EDD2526/edd-project-grup-dimecres-dc_c_seients/KiCad/proj_seients/proj_seients.kicad_pcb

## KiCad design KiCad/proj_seients/proj_seients.kicad_pcb (2026-04-28)

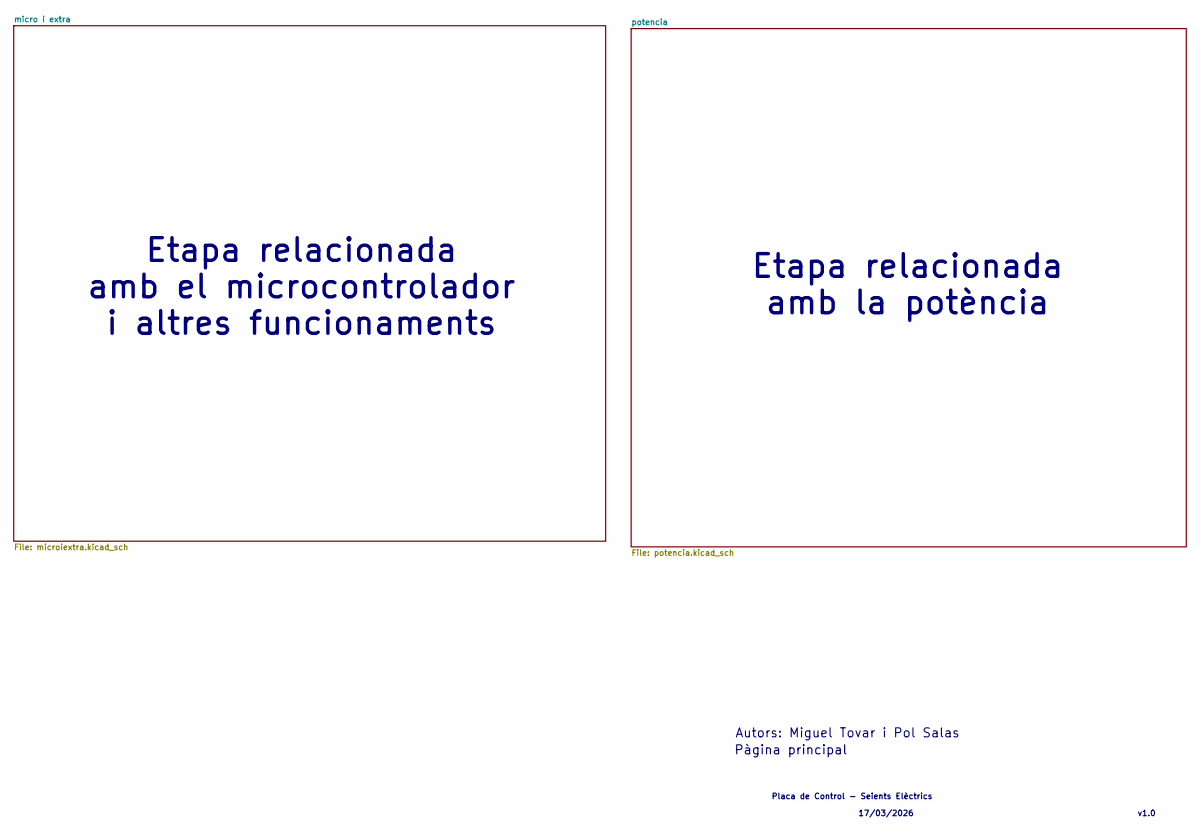
[picture p2: schematic proj_seients.kicad_sch]

Notes on the sheet:
v1.0
Etapa relacionada amb el microcontrolador i altres funcionaments
Placa de Control - Seients Elèctrics
Etapa relacionada amb la potència
17/03/2026
Pàgina principal
Autors: Miguel Tovar i Pol Salas

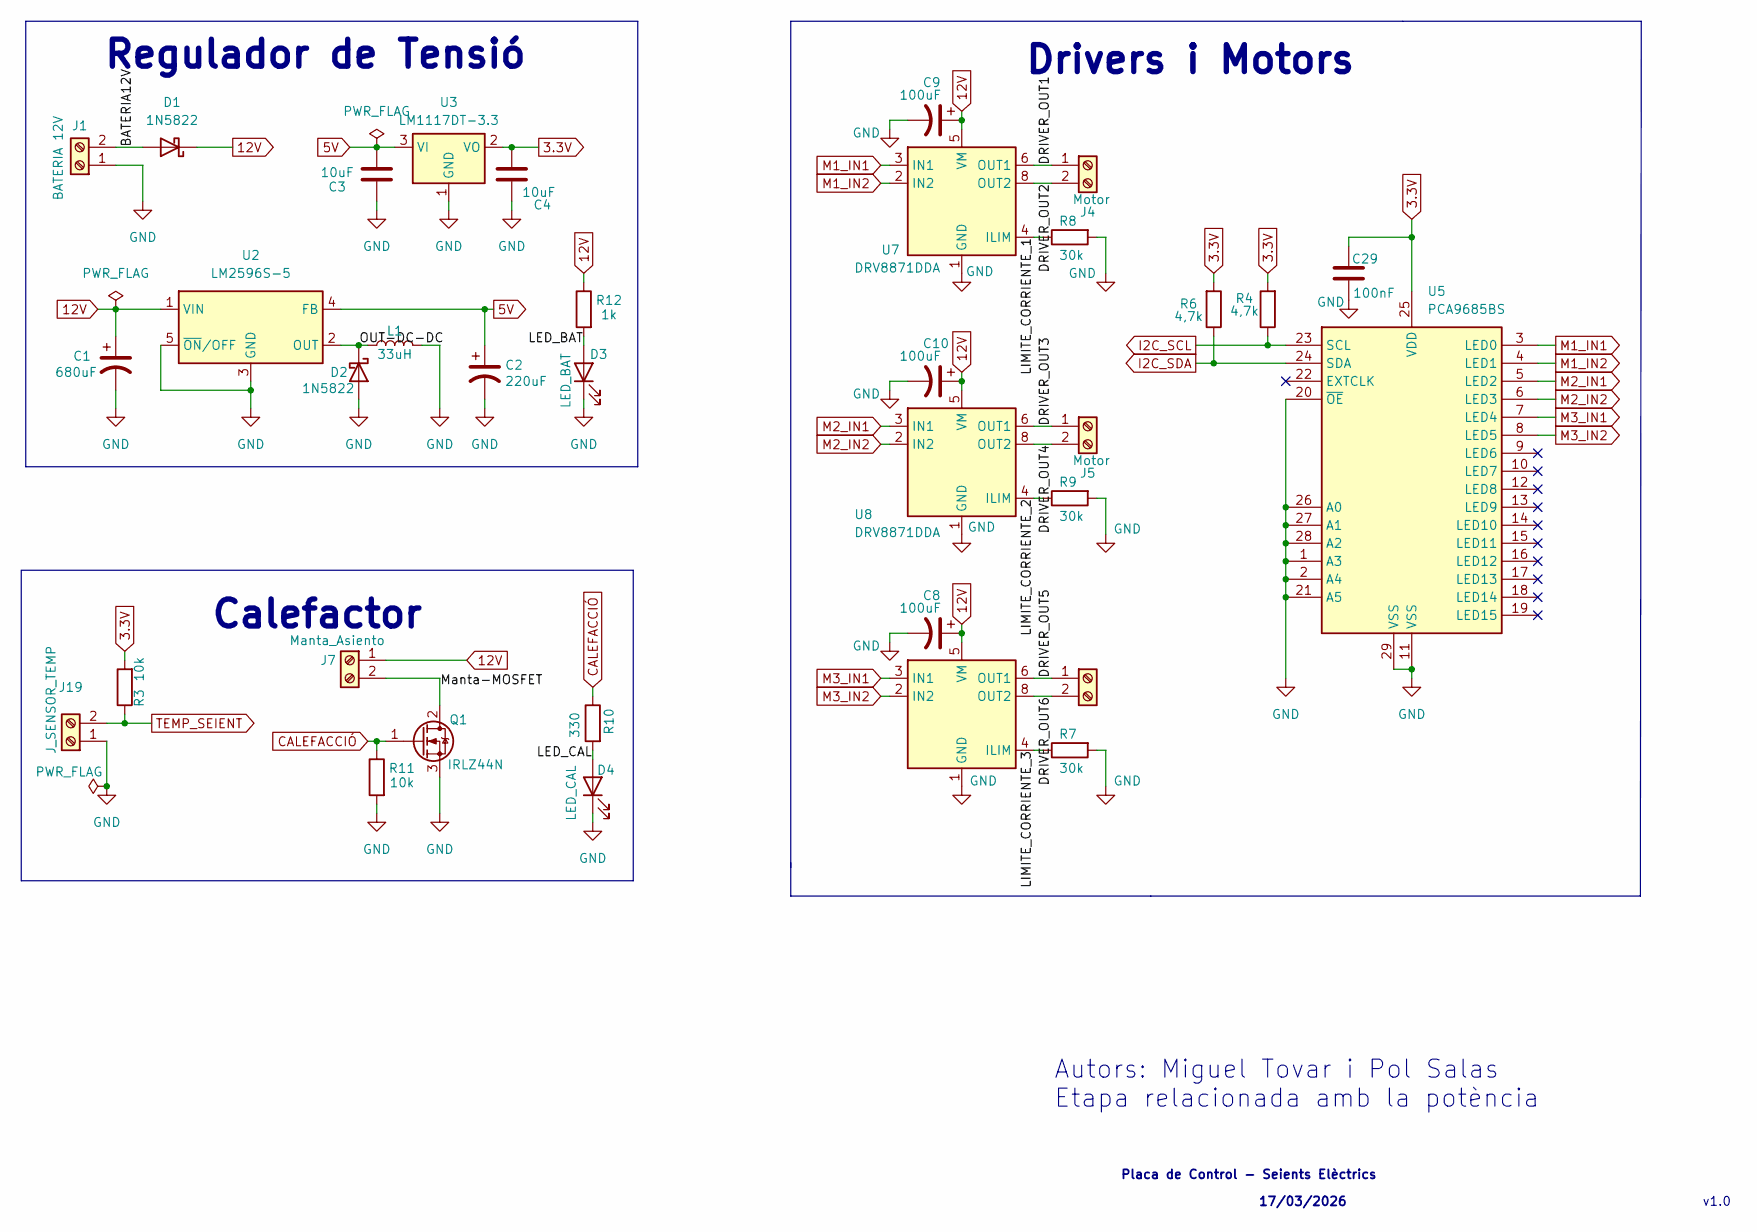
[picture p3: schematic potencia.kicad_sch]

Parts:
C1: 680uF; CP_Radial_D10.0mm_P5.00mm
C2: 220uF; CP_Radial_D8.0mm_P3.50mm
C3, C4: 10uF; C_0805_2012Metric
C8, C9, C10: 100uF; CP_Radial_D8.0mm_P3.50mm
C29: 100nF; C_0805_2012Metric
D1, D2: 1N5822; D_DO-201AD_P15.24mm_Horizontal
D3: LED_BAT; LED_0805_2012Metric
D4: LED_CAL; LED_0805_2012Metric
J1: BATERIA 12V; TerminalBlock_Phoenix_MKDS-1,5-2-5.08_1x02_P5.08mm_Horizont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
J4, J5, J6: Motor; TerminalBlock_Phoenix_MKDS-1,5-2-5.08_1x02_P5.08mm_Horizont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
J7: Manta_Asiento; TerminalBlock_Phoenix_MKDS-1,5-2-5.08_1x02_P5.08mm_Horizont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
J19: J_SENSOR_TEMP; TerminalBlock_Phoenix_MKDS-1,5-2-5.08_1x02_P5.08mm_Horizont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
L1: 33uH; L_Radial_D10.0mm_P5.00mm_Fastron_07M
Q1: IRLZ44N; TO-220-3_Vertical
R3, R11: 10k; R_0805_2012Metric
R4, R6: 4,7k; R_0805_2012Metric
R7, R8, R9: 30k; R_0805_2012Metric
R10: 330; R_0805_2012Metric
R12: 1k; R_0805_2012Metric
U2: LM2596S-5; TO-263-5_TabPin3
U3: LM1117DT-3.3; TO-252-3_TabPin2
U5: PCA9685BS; QFN-28-1EP_6x6mm_P0.65mm_EP4.25x4.25mm
U6, U7, U8: DRV8871DDA; Texas_HTSOP-8-1EP_3.9x4.9mm_P1.27mm_EP2.95x4.9mm_Mask2.4x3.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

Connections:
3.3V: C4.2, C29.2, R3.2, R4.2, R6.2, U3.2 (VO), U5.25 (VDD); also elsewhere on the board
5V: C2.1, C3.2, U2.4 (FB), U3.3 (VI); also elsewhere on the board
12V: C1.1, C8.1, C9.1, C10.1, D1.1 (K), J7.1, R12.1, U2.1 (VIN), U6.5 (VM), U7.5 (VM), U8.5 (VM); also elsewhere on the board
/potencia/BATERIA12V: D1.2 (A), J1.2
/potencia/DRIVER_OUT1: J4.1, U7.6 (OUT1)
/potencia/DRIVER_OUT2: J4.2, U7.8 (OUT2)
/potencia/DRIVER_OUT3: J5.1, U8.6 (OUT1)
/potencia/DRIVER_OUT4: J5.2, U8.8 (OUT2)
/potencia/DRIVER_OUT5: J6.1, U6.6 (OUT1)
/potencia/DRIVER_OUT6: J6.2, U6.8 (OUT2)
/potencia/LED_BAT: D3.2 (A), R12.2
/potencia/LED_CAL: D4.2 (A), R10.2
/potencia/LIMITE_CORRIENTE_1: R8.1, U7.4 (ILIM)
/potencia/LIMITE_CORRIENTE_2: R9.1, U8.4 (ILIM)
/potencia/LIMITE_CORRIENTE_3: R7.1, U6.4 (ILIM)
/potencia/Manta-MOSFET: J7.2, Q1.2 (D)
/potencia/OUT-DC-DC: D2.1 (K), L1.1, U2.2 (OUT)
CALEFACCIÓ: Q1.1 (G), R10.1, R11.1; also elsewhere on the board
GND: C1.2, C2.2, C3.1, C4.1, C8.2, C9.2, C10.2, C29.1, D2.2 (A), D3.1 (K), D4.1 (K), J1.1, J19.1, L1.2, Q1.3 (S), R7.2, R8.2, R9.2, R11.2, U2.3 (GND), U2.5 (~ON/OFF), U3.1 (GND), U5.1 (A3), U5.2 (A4), U5.11 (VSS), U5.20 (~OE), U5.21 (A5), U5.26 (A0), U5.27 (A1), U5.28 (A2), U5.29 (VSS), U6.1 (GND), U6.7 (GND), U6.9 (GND), U7.1 (GND), U7.7 (GND), U7.9 (GND), U8.1 (GND), U8.7 (GND), U8.9 (GND); also elsewhere on the board
I2C_SCL: R4.1, U5.23 (SCL); also elsewhere on the board
I2C_SDA: R6.1, U5.24 (SDA); also elsewhere on the board
M1_IN1: U5.3 (LED0), U7.3 (IN1)
M1_IN2: U5.4 (LED1), U7.2 (IN2)
M2_IN1: U5.5 (LED2), U8.3 (IN1)
M2_IN2: U5.6 (LED3), U8.2 (IN2)
M3_IN1: U5.7 (LED4), U6.3 (IN1)
M3_IN2: U5.8 (LED5), U6.2 (IN2)
TEMP_SEIENT: J19.2, R3.1; also elsewhere on the board

Notes on the sheet:
Regulador de Tensió
Placa de Control - Seients Elèctrics
17/03/2026
Drivers i Motors
Calefactor
Autors: Miguel Tovar i Pol Salas Etapa relacionada amb la potència
v1.0

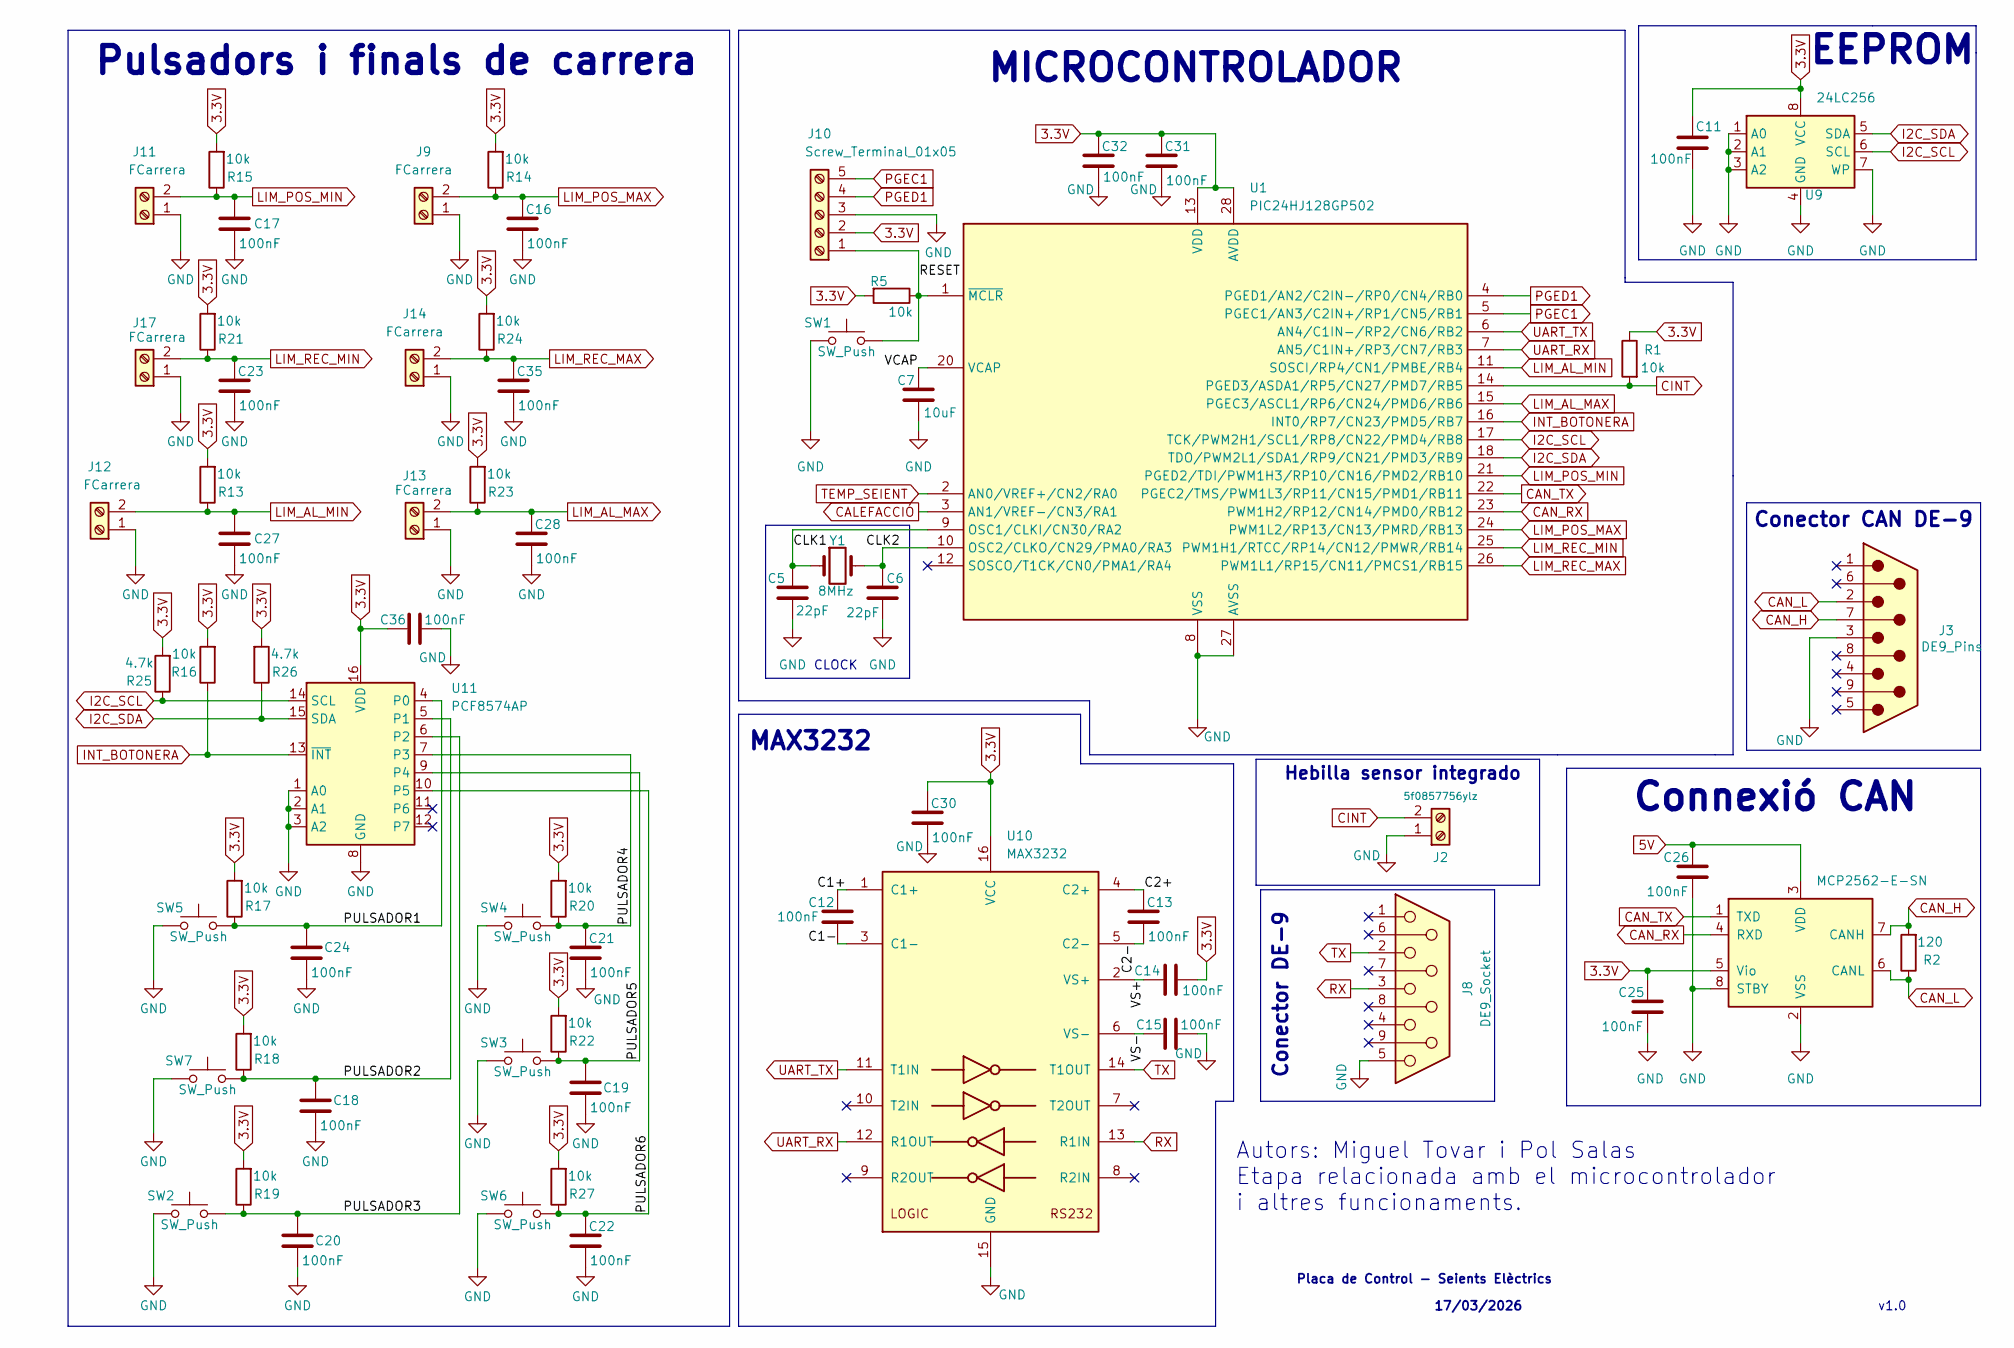
[picture p4: schematic microiextra.kicad_sch]

Parts:
C5, C6: 22pF; C_0805_2012Metric
C7: 10uF; C_0805_2012Metric
C11, C12, C13, C14, C15, C16, C17, C18, C19, C20, C21, C22, C23, C24, C25, C26, C27, C28, C30, C31, C32, C35, C36: 100nF; C_0805_2012Metric
J2: 5f0857756ylz; TerminalBlock_Phoenix_MKDS-1,5-2-5.08_1x02_P5.08mm_Horizont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
J3: DE9_Pins; DSUB-9_Pins_Horizontal_P2.77x2.84mm_EdgePinOffset9.40mm
J8: DE9_Socket; DSUB-9_Socket_Horizontal_P2.77x2.84mm_EdgePinOffset9.40mm
J9, J11, J12, J13, J14, J17: FCarrera; PinHeader_1x02_P2.54mm_Vertical
J10: Screw_Terminal_01x05; PinHeader_1x05_P2.54mm_Vertical
R1, R5, R13, R14, R15, R16, R17, R18, R19, R20, R21, R22, R23, R24, R27: 10k; R_0805_2012Metric
R2: 120; R_0805_2012Metric
R25, R26: 4.7k; R_0805_2012Metric
SW1, SW2, SW3, SW4, SW5, SW6, SW7: SW_Push; SW_PUSH_6mm
U1: PIC24HJ128GP502; SOIC-28W_7.5x17.9mm_P1.27mm
U4: MCP2562-E-SN; SOIC-8_3.9x4.9mm_P1.27mm
U9: 24LC256; SOIC-8_3.9x4.9mm_P1.27mm
U10: MAX3232; SOIC-16_3.9x9.9mm_P1.27mm
U11: PCF8574AP; DIP-16_W7.62mm
Y1: 8MHz; Crystal_HC49-U_Vertical

Connections:
3.3V: C11.1, C14.1, C25.2, C30.2, C31.2, C32.2, C36.2, J10.2, R1.1, R5.2, R13.2, R14.2, R15.2, R16.2, R17.2, R18.2, R19.2, R20.2, R21.2, R22.2, R23.2, R24.2, R25.2, R26.2, R27.2, U1.13 (VDD), U1.28 (AVDD), U4.5 (Vio), U9.8 (VCC), U10.16 (VCC), U11.16 (VDD); also elsewhere on the board
5V: C26.2, U4.3 (VDD); also elsewhere on the board
/micro i extra/C1+: C12.2, U10.1 (C1+)
/micro i extra/C1-: C12.1, U10.3 (C1-)
/micro i extra/C2+: C13.2, U10.4 (C2+)
/micro i extra/C2-: C13.1, U10.5 (C2-)
/micro i extra/CLK1: C5.2, U1.9 (OSC1/CLKI/CN30/RA2), Y1.1
/micro i extra/CLK2: C6.2, U1.10 (OSC2/CLKO/CN29/PMA0/RA3), Y1.2
/micro i extra/PULSADOR1: C24.2, R17.1, SW5.2, U11.4 (P0)
/micro i extra/PULSADOR2: C18.2, R18.1, SW7.2, U11.5 (P1)
/micro i extra/PULSADOR3: C20.2, R19.1, SW2.2, U11.6 (P2)
/micro i extra/PULSADOR4: C21.2, R20.1, SW4.2, U11.7 (P3)
/micro i extra/PULSADOR5: C19.2, R22.1, SW3.2, U11.9 (P4)
/micro i extra/PULSADOR6: C22.2, R27.1, SW6.2, U11.10 (P5)
/micro i extra/RESET: J10.1, R5.1, SW1.2, U1.1 (~MCLR)
/micro i extra/VCAP: C7.2, U1.20 (VCAP)
/micro i extra/VS+: C14.2, U10.2 (VS+)
/micro i extra/VS-: C15.2, U10.6 (VS-)
CALEFACCIÓ: U1.3 (AN1/VREF-/CN3/RA1); also elsewhere on the board
CAN_H: J3.7, R2.2, U4.7 (CANH)
CAN_L: J3.2, R2.1, U4.6 (CANL)
CAN_RX: U1.23 (PWM1H2/RP12/CN14/PMD0/RB12), U4.4 (RXD)
CAN_TX: U1.22 (PGEC2/TMS/PWM1L3/RP11/CN15/PMD1/RB11), U4.1 (TXD)
CINT: J2.2, R1.2, U1.14 (PGED3/ASDA1/RP5/CN27/PMD7/RB5)
GND: C5.1, C6.1, C7.1, C11.2, C15.1, C16.1, C17.1, C18.1, C19.1, C20.1, C21.1, C22.1, C23.1, C24.1, C25.1, C26.1, C27.1, C28.1, C30.1, C31.1, C32.1, C35.1, C36.1, J2.1, J3.3, J8.5, J9.1, J10.3, J11.1, J12.1, J13.1, J14.1, J17.1, SW1.1, SW2.1, SW3.1, SW4.1, SW5.1, SW6.1, SW7.1, U1.8 (VSS), U1.19 (VSS), U1.27 (AVSS), U4.2 (VSS), U4.8 (STBY), U9.1 (A0), U9.2 (A1), U9.3 (A2), U9.4 (GND), U9.7 (WP), U10.15 (GND), U11.1 (A0), U11.2 (A1), U11.3 (A2), U11.8 (GND); also elsewhere on the board
I2C_SCL: R25.1, U1.17 (TCK/PWM2H1/SCL1/RP8/CN22/PMD4/RB8), U9.6 (SCL), U11.14 (SCL); also elsewhere on the board
I2C_SDA: R26.1, U1.18 (TDO/PWM2L1/SDA1/RP9/CN21/PMD3/RB9), U9.5 (SDA), U11.15 (SDA); also elsewhere on the board
INT_BOTONERA: R16.1, U1.16 (INT0/RP7/CN23/PMD5/RB7), U11.13 (~INT)
LIM_AL_MAX: C28.2, J13.2, R23.1, U1.15 (PGEC3/ASCL1/RP6/CN24/PMD6/RB6)
LIM_AL_MIN: C27.2, J12.2, R13.1, U1.11 (SOSCI/RP4/CN1/PMBE/RB4)
LIM_POS_MAX: C16.2, J9.2, R14.1, U1.24 (PWM1L2/RP13/CN13/PMRD/RB13)
LIM_POS_MIN: C17.2, J11.2, R15.1, U1.21 (PGED2/TDI/PWM1H3/RP10/CN16/PMD2/RB10)
LIM_REC_MAX: C35.2, J14.2, R24.1, U1.26 (PWM1L1/RP15/CN11/PMCS1/RB15)
LIM_REC_MIN: C23.2, J17.2, R21.1, U1.25 (PWM1H1/RTCC/RP14/CN12/PMWR/RB14)
PGEC1: J10.5, U1.5 (PGEC1/AN3/C2IN+/RP1/CN5/RB1)
PGED1: J10.4, U1.4 (PGED1/AN2/C2IN-/RP0/CN4/RB0)
RX: J8.3, U10.13 (R1IN)
TEMP_SEIENT: U1.2 (AN0/VREF+/CN2/RA0); also elsewhere on the board
TX: J8.2, U10.14 (T1OUT)
UART_RX: U1.7 (AN5/C1IN+/RP3/CN7/RB3), U10.12 (R1OUT)
UART_TX: U1.6 (AN4/C1IN-/RP2/CN6/RB2), U10.11 (T1IN)

Notes on the sheet:
Hebilla sensor integrado
Conector DE-9
MICROCONTROLADOR
v1.0
17/03/2026
CLOCK
Placa de Control - Seients Elèctrics
Autors: Miguel Tovar i Pol Salas Etapa relacionada amb el microcontrolador i altres funcionaments.
EEPROM
MAX3232
Conector CAN DE-9
Pulsadors i finals de carrera
Connexió CAN

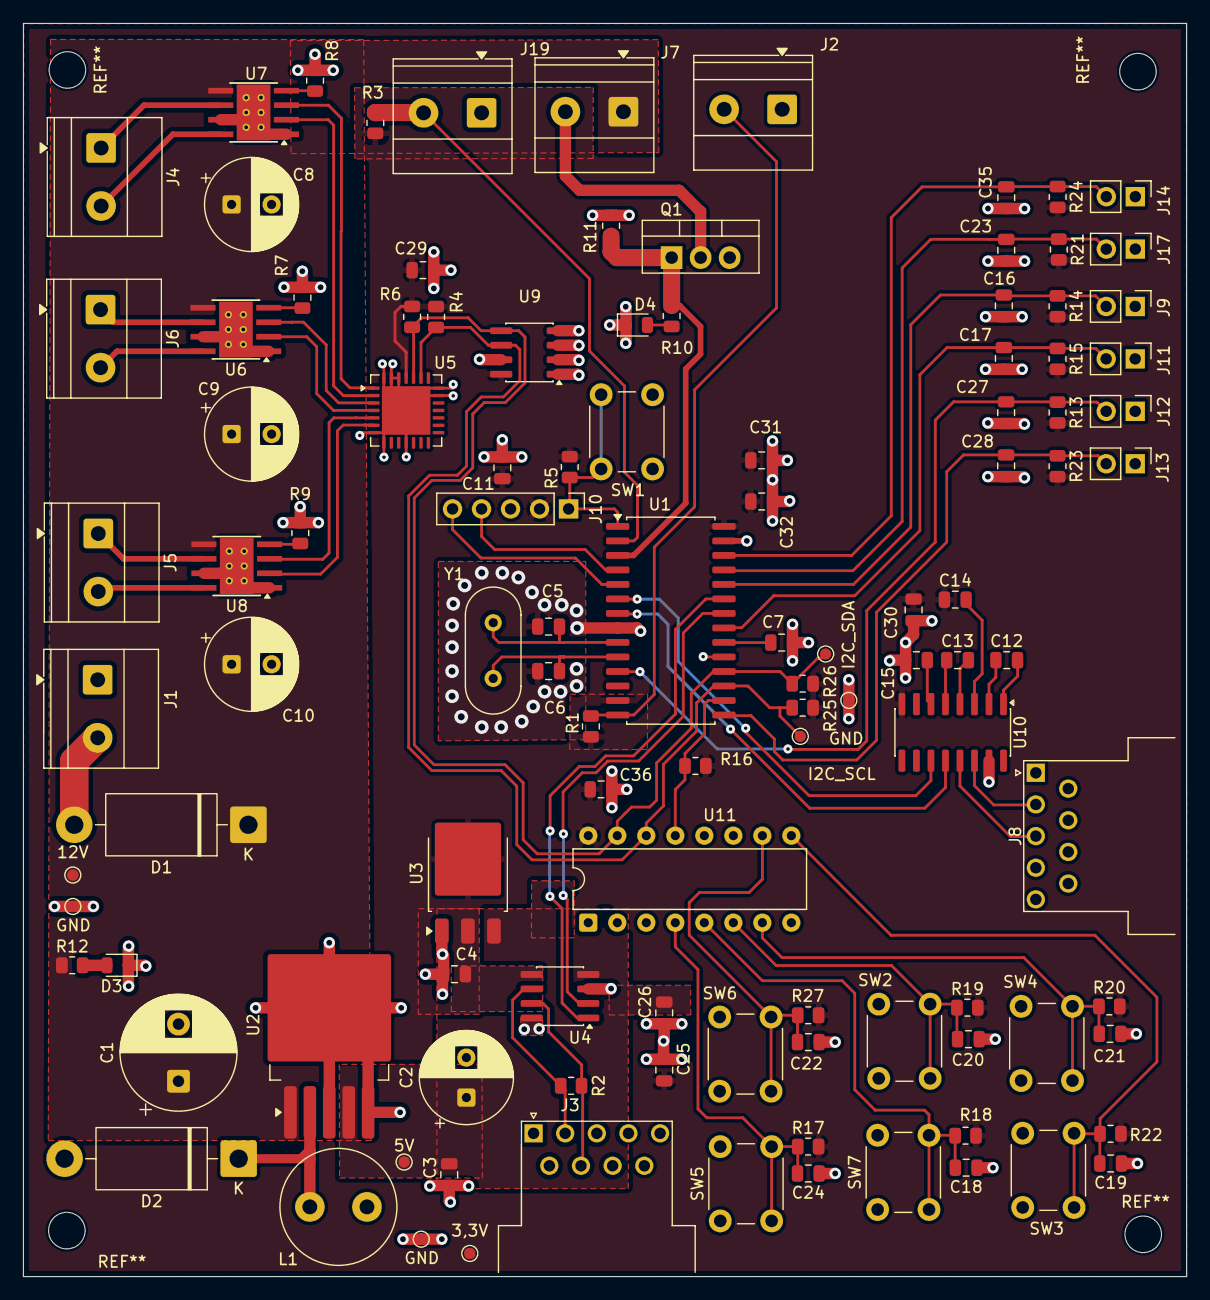
[picture p5: board proj_seients.kicad_pcb from above]

Board: 2 copper layers, 101.8 x 109.7 mm, 110 parts (0 on the bottom side), 62 nets.

Other parts of the board:
3,3V, 5V, 12V: TestPoint_Pad_D1.0mm
GND: TestPoint_Pad_D1.0mm
GND#2, GND#3: TestPoint_Pad_D1.0mm
I2C_SCL, I2C_SDA: TestPoint_Pad_D1.0mm

Their connections:
3.3V: 3,3V.1; also elsewhere on the board
5V: 5V.1; also elsewhere on the board
12V: 12V.1; also elsewhere on the board
GND: GND.1, GND#2.1, GND#3.1; also elsewhere on the board
I2C_SCL: I2C_SCL.1; also elsewhere on the board
I2C_SDA: I2C_SDA.1; also elsewhere on the board
