EDD2526/edd-project-grup-dimecres-dc_c_seients/(commit log)

2026-03-11 Projecte KiCad
    [proj_seients.kicad_pcb, proj_seients.kicad_sch]
2026-03-16 Afegit Regulador de Tensió
2026-03-16 Afegit Regulador de tensió + Sensor Cinturó + CAN
    [proj_seients.kicad_sch]
2026-03-17 Afegit drivers + motors
    [proj_seients.kicad_sch]
2026-03-17 Modificació de recuadres
    [proj_seients.kicad_sch]
2026-03-17 Afegit calefacor + alguns LEDs
    [proj_seients.kicad_sch]
2026-03-17 Afegit EEPROM
    [proj_seients.kicad_sch]
2026-03-17 Afegit MAX3232
    [proj_seients.kicad_sch]
2026-03-17 Tot Afegit
    [proj_seients.kicad_sch]
2026-03-17 Canvi Connexió AVDD i AVSS
    [proj_seients.kicad_sch]
2026-03-17 Correcions proposades
    [proj_seients.kicad_sch, untitled.kicad_sch]
2026-03-17 Canvis visuals
    [microiextra.kicad_sch, potencia.kicad_sch, proj_seients.kicad_sch]
2026-03-18 eliminat arxiu unnamed que era incorrecte
    [untitled.kicad_sch]
2026-03-18 canvi r pull driver
    [potencia.kicad_sch]
2026-03-20 Canvi de TCAN i Afegit CAN DE.9
    [microiextra.kicad_sch, potencia.kicad_sch, proj_seients.kicad_sch]
2026-03-20 Afegit C protecció als 5V del CAN
    [microiextra.kicad_sch]
2026-03-21 Canvis de pulsadors, estètica dels drivers i commentaris extres
    [microiextra.kicad_sch, potencia.kicad_sch]
2026-03-21 Canvi taula de components al readme
2026-03-21 Huellas agefides
    [microiextra.kicad_sch, potencia.kicad_sch]
2026-03-22 Començament layout
    [proj_seients.kicad_pcb]
2026-03-22 Versió 1.0 Layout
    [microiextra.kicad_sch, potencia.kicad_sch, proj_seients.kicad_pcb, proj_seients.kicad_sch]
2026-03-22 Versió 1.1 Layout
    [proj_seients.kicad_pcb]
2026-03-22 Versió 2.0 Layout
    [proj_seients.kicad_pcb]
2026-03-22 Versió 2.1 Layout
    [proj_seients.kicad_pcb]
2026-03-23 Versió 2.2 Layout
    [proj_seients.kicad_pcb]
2026-03-23 Afegit títol i autors a la placa
    [proj_seients.kicad_pcb]
2026-03-24 Version V2.4
    [proj_seients.kicad_pcb]
2026-03-24 Exclusió de dos errors justificats
    [microiextra.kicad_sch, potencia.kicad_sch]
2026-03-24 Versió 3.0
    [proj_seients.kicad_pcb]
2026-03-24 Actualización del diagrama de bloques
2026-03-25 Añadido sensor TMP102 a la lista de componentes
2026-04-07 Fix alguns errors en millora-pcb
    [proj_seients.kicad_pcb]
2026-04-27 Añadido BOM sin terminar
    [proj_seients.csv, proj_seients_BOM.xlsx]
2026-04-27 Archivo excel quitado para evitar problemas
    [proj_seients_BOM.xlsx]
2026-04-28 Añadido BOM, Gerbers, CPL
    [bom.csv, designators.csv, positions.csv, proj_seients.csv, proj_seients.kicad_pcb]
